FauzaanSharieff/Vierbeiner/README.md

# 🐾 Vierbeiner

## Project Description
Vierbeiner is a four-legged mobile robot, designed and developed from scratch, featuring three degrees of freedom for dynamic movement. It is controlled via a radio controller, offering precision and responsiveness.  
What sets Vierbeiner apart from most IoT-based quadruped robots is its innovative two-leg algorithm, where two legs simultaneously adjust their positions relative to the world frame during movement. This approach surpasses the conventional one-leg algorithm by enhancing speed and efficiency per step, making Vierbeiner both agile and optimized for real-world applications.  
At the heart of Vierbeiner lies the versatile ATmega2560 microcontroller, whose abundance of PWM pins eliminates the need for external drivers, streamlining the robot's design and functionality.  
This project embodies the principles of practical engineering and modern robotics optimization. Special thanks to Arnav Bajaj for his invaluable assistance in soldering the supply line—an indispensable contribution that made this project a reality.

---

## 🎥 Working Demo
The working can be seen here:  
**https://www.linkedin.com/feed/update/urn:li:activity:7270960458445029376/**

---

## 🧩 Reference Frame
The code works based on this frame available online:  
**https://www.aliexpress.com/item/32977418622.html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,scm-url:1007.40050.354490.0,pvid:40a293ab-e8c8-4e20-80bf-938cf284bf85,tpp_buckets:668%232846%238111%231996&isseo=y&pdp_npi=4%40dis%21EUR%2116.66%2114.99%21%21%2116.90%2115.20%21%40211b430817383179106408574e4ed2%2166799024587%21rec%21DE%216160209058%21XZ&utparam-url=scene%3ApcDetailTopMoreOtherSeller%7Cquery_from%3A**

---

## 📚 More Information
For more information, check the documentation available in the repository, or contact me via my email.
