FauzaanSharieff/Vierbeiner/Vierbeiner.pdf

VIERBEINER DEVELOPMENT DOCUMENTATION

“The QuadBot emerged due to a need of making a relavely complex project in order to get equipped with the skills required to make my CV more impeccable. The possibility of applying for an internship in my third semester made me realise how excruciangly lacking my skillset is. This led me to change my view from “learning the skills and then start a project based on the things I know” to “start a project and learn all the skills needed to complete it”.”

Descripon:
Vierbeiner is a four-legged mobile robot controlled by a radio controller. Designed and developed from scratch, Vierbeiner is a project implemented to aid learning. It has three degrees of freedom a horizontal plane. What makes it unique from the general IoT based 4-legged robots is that it uses a dual-leg algorithm opposed to the single-leg algorithm. This gives Vierbeiner more speed and efficiency.

Incepon:
Vierbeiner is a project which aims to build a four-legged mobile robot. The first phase of the project aims to make the robot mobile with the help of a controller. The second phase contains different forms of control, using environmental sensors, or hand gesture recognion algorithms. The third phase will see Vierbeiner become autonomous, and rely solely on itself for control. Although the idea was perceived at the beginning of the year 2024, acve development did not start unl the 30th of October, 2024. The first phase of the project was completed on the 5th of December, 2024. However, at this point, further development towards the next phases was deemed unlikely to proceed.

Electronic Design:
Vierbeiner is powered by a 6V source. A 2S 2200mAh baery along with a stepdown convertor was used as the power source. They powered a circuit board which had a common supply and ground to which the MG90S motors and the Arduino Mega were connected. The analog pins of the motors were also connected to the analog outputs of the Arduino Mega through the same peroard.

Soware Design:
Vierbeiner was coded using C++ using the Arduino IDE and its library. Object-Oriented Programming concepts like Polymorphism and Abstracon were extensively used. Use of funcons and variables for their own use made change of parameters and development of new movement algorithms simpler and faster.

Structural Design:
Inially wanng to 3D print a custom frame, the connecng joints were purchased from a third-party seller. For the base that gives the robot stability to carry out the dual-leg algorithm, header pins were used due to their low surface area and long reach across the ground. Epoxy puy was used to make the moulds which were placed on the header pins, with the moulds having holes that fit the legs. This design gave the base just enough fricon to not only push against the ground, but also low enough allow the base in contact with the ground to change the distance between each other during movement.

List of components used:

### 1. Arduino Mega 2560 2. MG90S motors

3. 2S 2200 mAh LiPo Baery (with XT60 connector)

### 4. Stepdown convertor 5. Plasc frame

6. 20 AWG wires

### 7. Jumper wires 8. Double-sided peroard 9. Switch 10. nRF24L01 Radio Module (Communicaon) 11. Unseparated Header Pins 12. Epoxy Puy 13. Arduino Uno (Controller) 14. Joyscks (Controller) 15. Breadboard (Controller)

Development Log:
30.10.2024
One of the major problems of making this robot from scratch was the structure. Inially having no clue regarding how to proceed, I researched about 3D prinng. I decided to learn Fusion 360 in order to model the frame and have it printed. Since this was not an easy task, I found another alternave – I found pan and lt mounts used for cameras, and decided to use those as the primary mobile parts. However, it was an unesthec approach, and the problem of the end limbs was sll present.

31.10.2024
I realised there were ready-made frames available on the internet. There was only one available 12 DoF frame available, which was purchased. The following components were also purchased:
- Arduino Mega
- Arduino Uno

- x12 SG90 Servo Motors
- Bluetooth Module
- Breadboard

The Arduino Mega was chosen to control the robot due to the sufficient availability of PWM pins.

02.11.2024
The design of the power supply was realised, and the following components were ordered:

### 1. x2 2S 2200MaH 35C LiPo Baeries

2. 14 AWG Wire

### 3. Potenometers 4. Step Down Convertor 5. Perf-board

Each servo motor needs 5V supply, and the stall current is 0.75A. This means the maximum current that can be drawn is 9A. Due to this, I could not power the motors through the microcontroller or the breadboard. Therefore, 14 AWG wires, a voltage regulator and a perf-board were ordered to have an external power supply for the motors. To power the motors, the 7.4V supply from the baery is stepped down to 5V and connected on the perf-board in parallel to 12 supply lines leading to the motors. The ground lines are connected on the same perf-board back to the baery. The Arduino is connected directly to the baery, and the voltage is stepped down by its built-in regulator.

03.11.2024
Designed the structure of the code and modelled the basic kinemacs of the robot.

### 1. Servo Delay movement 2. Funcon Declaraons 3. Derived Servo Class for custom data members

Realised that the wrong type of servo was ordered, cancelled order and ordered MG90 motors.

04.11.2024

### 1. Solved the motors’ basic mul-step problem. Several motors can now be moved at the same

me, at a controlled pace.
2. Standardised the orientaons of all motors.
3. Solved the rotaonal, translaonal and redundant kinemacs.
4. Forward algorithm is completed.
5. Ordered new components.
6. Changed control transmission medium, from Bluetooth to radio.

7. Devised a kill switch operaon.

For the forward algorithm, robot can be, at any point, performing on of the three funcons: stepRight(), stepLe() and stance() (Excluding rotaon() because it has not yet been defined). Here’s what stepRight() does:

### 1. Moves translaonal motors 0 and 2 up if they are not up 2. Moves rotaonal motors to stepRight() threshold 3. Moves translaonal motors 0 and 2 down 4. Moves translaonal motors 1 and 3 up 5. Moves rotaonal motors to stance state (translaonal motors 1 and 3 are sll up)

stepLe() follows the same steps as above, but of course towards the inverse counterparts.

Since the rotaonal motors are at stance state at the end of stepRight() and stepLe(), stance() only lowers any translaonal motors that may be up. To make sure that the robot is in stance state, all motors will be updated to match their stance angles.

Due to the way in which stepRight() and stepLe() reach a semi-stance state at the end of their execuons, all state transions between the three forward algorithm funcons can be achieved smoothly.

Orientaons of the motors are as follows:
- Orienng front-right rotaonal motor to 0 at “closed, poinng right”.
- Orienng front-le rotaonal motor to 0 at “open, poinng right”.
- Orienng hind-le rotaonal motor to 0 at “closed, poinng le”.
- Orienng hind-right rotaonal motor to 0 at “open, poinng le”.
- Orienng the translaonal motors to 0 at “stretched outwards, poinng sideways”.
- Orienng the redundant motors to 0 at “closed inwards, poinng upwards”.

Components that were ordered:

### 1. Kill switch (controller)

2. 10cm Jumper wires

### 3. Radio module 4. Joyscks

05.11.2024
Made major development on code.

### 1. Standardised and isolated basic movements like rotaon and translaon. Using threshold()

and funcons like moveEvenUp(), total control was achieved which made making other movement algorithms way easier.

### 2. Made algorithms for movements (forward-backward, le-right, rotaon) in 3 degrees of

freedom on a 2D plane.
3. Completed all actuang parts of the code.
Only missing part of the code is the radio module for control. Code produces no errors, but detailed checking for logical errors is yet to be done.

07.11.2024

### 1. Created controller code

2. Setup radio communicaon code and joysck control.
3. Created first Diagonal movement algorithm.

08.11.2024
Ordered the following components:

### 1. High current switch for power supply 2. Header pins for peroard 3. Gesture recognion sensor

09.11.2024 – 13.11.2024
1. Soldered the peroard for the supply line. Changed the supply lines layout to directly fit analog, ground and supply pins of the motors along with the PWM output pins from the Mega.
2. Tested the hind rotaonal motors, which led to unexpected behaviour due to faulty code. Soluon to the problem was, however, not found.

14.11.2024
Extensively tried seng up radio communicaon but failed.

16.11.2024
Tried seng up radio communicaon again, but failed. Searched procedure for Bluetooth communicaon, but did not work on it further.

19.11.2024

### 1. Patched the hind rotaonal motors’ code. (Changed threshold values in threshold()

parameters and replaced move() with threshold() itself.)
2. Conducted first successful test for above menoned motors. Used local controller for tesng.
3. Aached the hind rotaonal motors to the frame.

20.11.2024
Realised that operang current of the MG90Ss was 120-250 mA, and at any moment, a maximum of four motors would be operang. Therefore, at the point where maximum power was being drawn, there would only be 1A of operang current required along with 80 mA of 8 staonary motors (10 mA each when staonary) and maximum of 600 mA through the Mega. Therefore, it is unlikely for the current to exceed even 3A.

### 1. Changed supply parameters: 20 AWG wires and 3A rated convertor were deemed enough for

transfer of power.

### 2. Tried to configure the convertor once again, but ended in another frustrang failure

21.11.2024
1. Successfully configured the convertor.
2. Soldered the enre supply line.
3. Tested rotaonal motors using the supply line.

22.11.2024
Aached the translaonal motors. An error in the translaonal motor kinemacs was found. The designed behaviour suited only the right translaonal motors and not the le. Therefore, their movement kinemacs were redesigned. Le and right translaonal motors now have different threshold values.

24.11.2024
Aached redundant motors. All motors were tested and are funconing perfectly. The enre frame has been assembled. Aached the convertor and peroard under the frame using adhesive double tape. Le redundant motor kinemacs were changed to compliment the new changes.
A problem regarding the structure has arisen – some of the screws get loose quickly and have to be ghtened every few minutes. Another worse problem is that each joint is not perfectly firm in terms of connecons, and the plasc tends to bend under stress. These ny errors add up to cause an overall bend when the robot stands on its own weight.
Planned on using connected header pins as a base, using epoxy puy to connect I perpendicular to the foot.

27.11.2024
Tried fixing the frame issues with no avail. Replaced the motors by other motors in translaonal and redundant posions, considering the possibility that the problem was with motor threads. Although it did help up to a certain limit, the problems were sll evident. Considered other soluons like applying super gel on the screw and nut contact, and applying puy in the rotaonal cap hole to keep it in place.
Realised that the small screws holding the rotaonal motors were geng loose due to the larger radius of the frame hole.

28.11.2024
Tried pung cardboard pieces in between the motor and frame connecon so as to push the motor outwards and close the gap. Worked fine, but the cap hole issue for two rotaonal motors was sll present, despite being reduced significantly. It has been planned to just connect the header pins base to lower the angular lt that causes the cap to bend and get removed. Overall, there has been a significant improvement in the frame structure despite there sll being a droop.

29.10.2024

### 1. Organised all the wires up to a certain limit 2. Implemented a switch for the robot which returned the loop funcon when switched off 3. Tested Vierbeiner for the first me

At first it was just moving about its own posion and not pushing forward. This is was due to two reasons. First, the surface contact of the base of the legs with the ground was very small due to the ny leg base. Because of this, there was not enough fricon to push the robot forward. Second, the robot could not balance on two legs, so three legs moved while having contact with the ground, and since the legs were not raised, nothing happened.
I then held the two legs which were supposed to be in contact with the ground in posion as they would be in the case of a stable base, and then the robot pushed forward. Vierbeiner walked for the first me, even if it was with assistance.
It is going to be quite a challenge to aach the base considering the nature of the point of contact. There has to be just enough fricon to push the robot forward, but also not too much in order to let the distance between the points of contact with the ground decrease during movement.
30.12.2024
Made the puy mould for the legs. Instead of making a permanent connecon between the legs and the header pins, I moulded the puy on the header pins such that the legs could just slide in and out.

1.12.2024

The mould was ready but the holes were too small to fit inside. Just made a temporary fix using tape, and Vierbeiner walked for the first me without assistance. Changed the translaonal up and down values so as to counteract the droop and not have contact with the ground, and the posture of the robot improved by a lot, now having more height and stability. Even the droop was fixed up to a certain limit. Made new moulds to fit the legs beer.

3.12.2024
Made the controller using the radio module. Implemented the rotaon algorithm. Tried to get the gesture sensor to work for quite a while but did not succeed.

5.12.2024
Project Vierbeiner was complete. It walked flawlessly, controlled by the radio controller.
